breakeryu/OPENIB_RP2040/hardware/inno_Bottom_borad/06_PRODUCT/SMT_Bill of Materials-iono_bottom_pico.xls

Comment | Description | Designator | Footprint | Quantity | 编号
10nF 50V | 贴片电容 | C1 | 0402_C | 1 | C272878
220uF 16V | 贴片铝电解电容 8x10.2mm | C2 | SMD-EC-F8 | 1 | C87861 (https://item.szlcsc.com/89039.html)
1uF 50V | 贴片电容 | C3, C5 | 0603_C | 2 | C342951
47uF 50V | 贴片铝电解电容 | C4, C9 | SMD-EC-F6.3 | 2 | C88677
100nF 50V | 贴片电容 | C6, C10 | 0402_C | 2 | C152814
10uF (106) 10% 25V | 贴片电容 | C7, C8 | 0603_C | 2 | C76614
S1M | 肖特基二极管 | D1, D7 | DO-214AC | 2 | C161744
RS2MA-13-F | B230A-13-F,SCHOTTKY RECTIFIER | D2 | DIOD-SMA-1K | 1 | C156336
B340A-13-F | Transient Voltage Suppressor, 6.40 to 231 V, 16 V Stand-off Voltage, Uni-Directional, -55 to 155 degC, 2-pin DO-214AC, Pb-Free, Tape and Reel | D3 | DO-214AC | 1 | C85098
BAT54S,215 | 肖特基二极管 | D4, D8 | SOT-23-3 | 2 | C47546
SM6T33A | 3A 肖特基二极管 | D5 | DO-214AA | 1 | C133690
SS34-SMB(DO-214AA) | 3A 肖特基二极管 | D6 | DO-214AA | 1 | C1884574
MMSZ8V2T1G | Fast Switching Diode, 100 V, 0.15 A,?-65 to 150 degC,?2-Pin?SOD123,?RoHS,?Tape and Reel | D9, D10, D11, D12, D13 | SOD-123-1A | 5 | C235988
mSMD110-33V | 贴片保险，自恢复 | F1 | 1812_R | 1 | C70119
JK-SMD1210-005 | 贴片保险，自恢复 | F2, F3 | 1210_R | 2 | C409801
MWSA1004S-220MT | 功率电感 | L1 | MWSA1004S | 1 | C408489
BC817 | NPN贴片三极管 | Q1, Q3, Q4, Q5, Q6 | SOT-23-3 | 5 | C475629
BCX53-16 | PNP贴片三极管 | Q2 | SOT89_M | 1 | C713685
330K ±1% | 贴片电阻 | R1, R13 | 0402_R | 2 | C413116
45K3 ±1% | 贴片电阻 | R2, R14 | 0402_R | 2 | C144759
47K ±1% | 贴片电阻 | R3, R7, R10, R15, R18, R22 | 0402_R | 6 | C93943
1K8 ±1% | 贴片电阻 | R4, R16 | 0402_R | 2 | C102844
10KΩ ±1% | 贴片电阻 | R5, R12，R8, R20 | 0402_R | 4 | C144807
2K2±1% | 贴片电阻 | R6, R17 | 0402_R | 2 | C114762
3.24KΩ ±1% | 贴片电阻 | R9 | 0402_R | 1 | C11457
4K7 ±1% | 贴片电阻 | R19, R24, R25, R26, R27, R32, R33, R34, R35 | 0402_R | 9 | C105871
6K8 ±1% | 贴片电阻 | R21 | 0402_R | 1 | C93940
3K3 ±1% | 贴片电阻 | R28, R31 | 0402_R | 2 | C325420
1K ±1% | 贴片电阻 | R29, R30 | 0402_R | 2 | C144789
TPS5430DDA | 5.5V to 36V Input, 3A, 500kHz Step-Down Converter 8-SO PowerPAD 0 to 0 | U1 | DDA0008J_L | 1 | C9864
MCP607T-I/SN | Dual Operational Amplifier, 3 to 32 V, 0 to 70 degC, 8-Pin SOIC (D), Green (RoHS & no Sb/Br), Tape and Reel | U2 | D0008A_L | 1 | C411629
SY6280AAAC | USB电子开关，电流保护 | U3 | SOT-23-5 | 1 | C207620
