breakeryu/OPENIB_RP2040/hardware/inno_Bottom_borad/06_PRODUCT/iono_bottom_pico.DXF

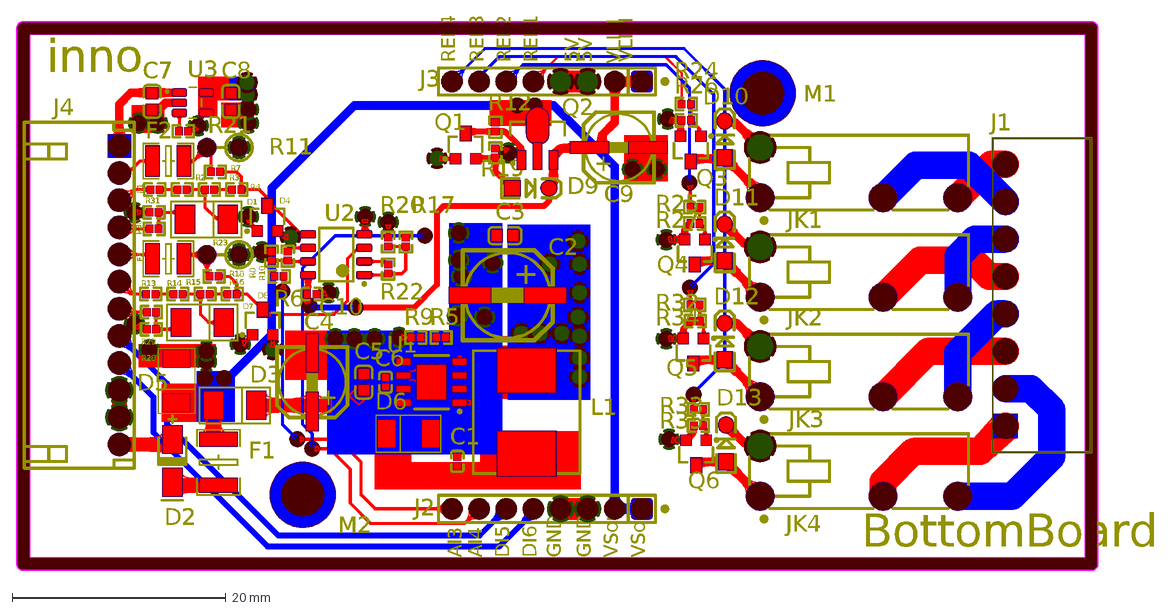
[picture p13: CAD file, 2023-02-28]
hardware/inno_Bottom_borad/06_PRODUCT/iono_bottom_pico.DXF
BottomBoard
inno
VSout
GND
DI6
DI5
AI4
AI3
VLIM
5V
REL1
REL2
REL3
REL4
M2
M1
U3
U2
U1
R35
R34
R33
R32
R31
R30
R29
R28
R27
R26
R25
R24
R23
R22
R21
R20
R19
R18
R17
R16
R15
R14
R13
R12
R11
R10
R9
R8
R7
R6
R5
R4
R3
R2
R1
Q6
Q5
Q4
Q3
Q2
Q1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
