breakeryu/OPENIB_RP2040/software/ionoRp2040/src/mpu6050/examples/MPU6050_DMP6_using_DMP_V6v12/MPUplane/data/biplane.obj

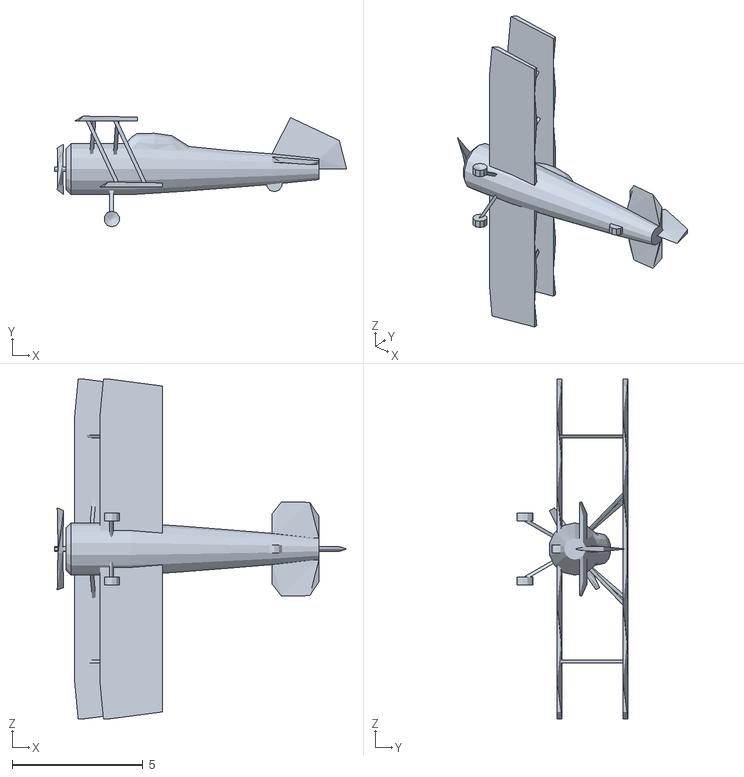
[picture p14: CAD file, 2023-02-28]
software/ionoRp2040/src/mpu6050/examples/MPU6050_DMP6_using_DMP_V6v12/MPUplane/data/biplane.obj
11.2 x 4.23 x 13.0
