breakeryu/OPENIB_RP2040/hardware/iono_pico/iono_pico.pdf

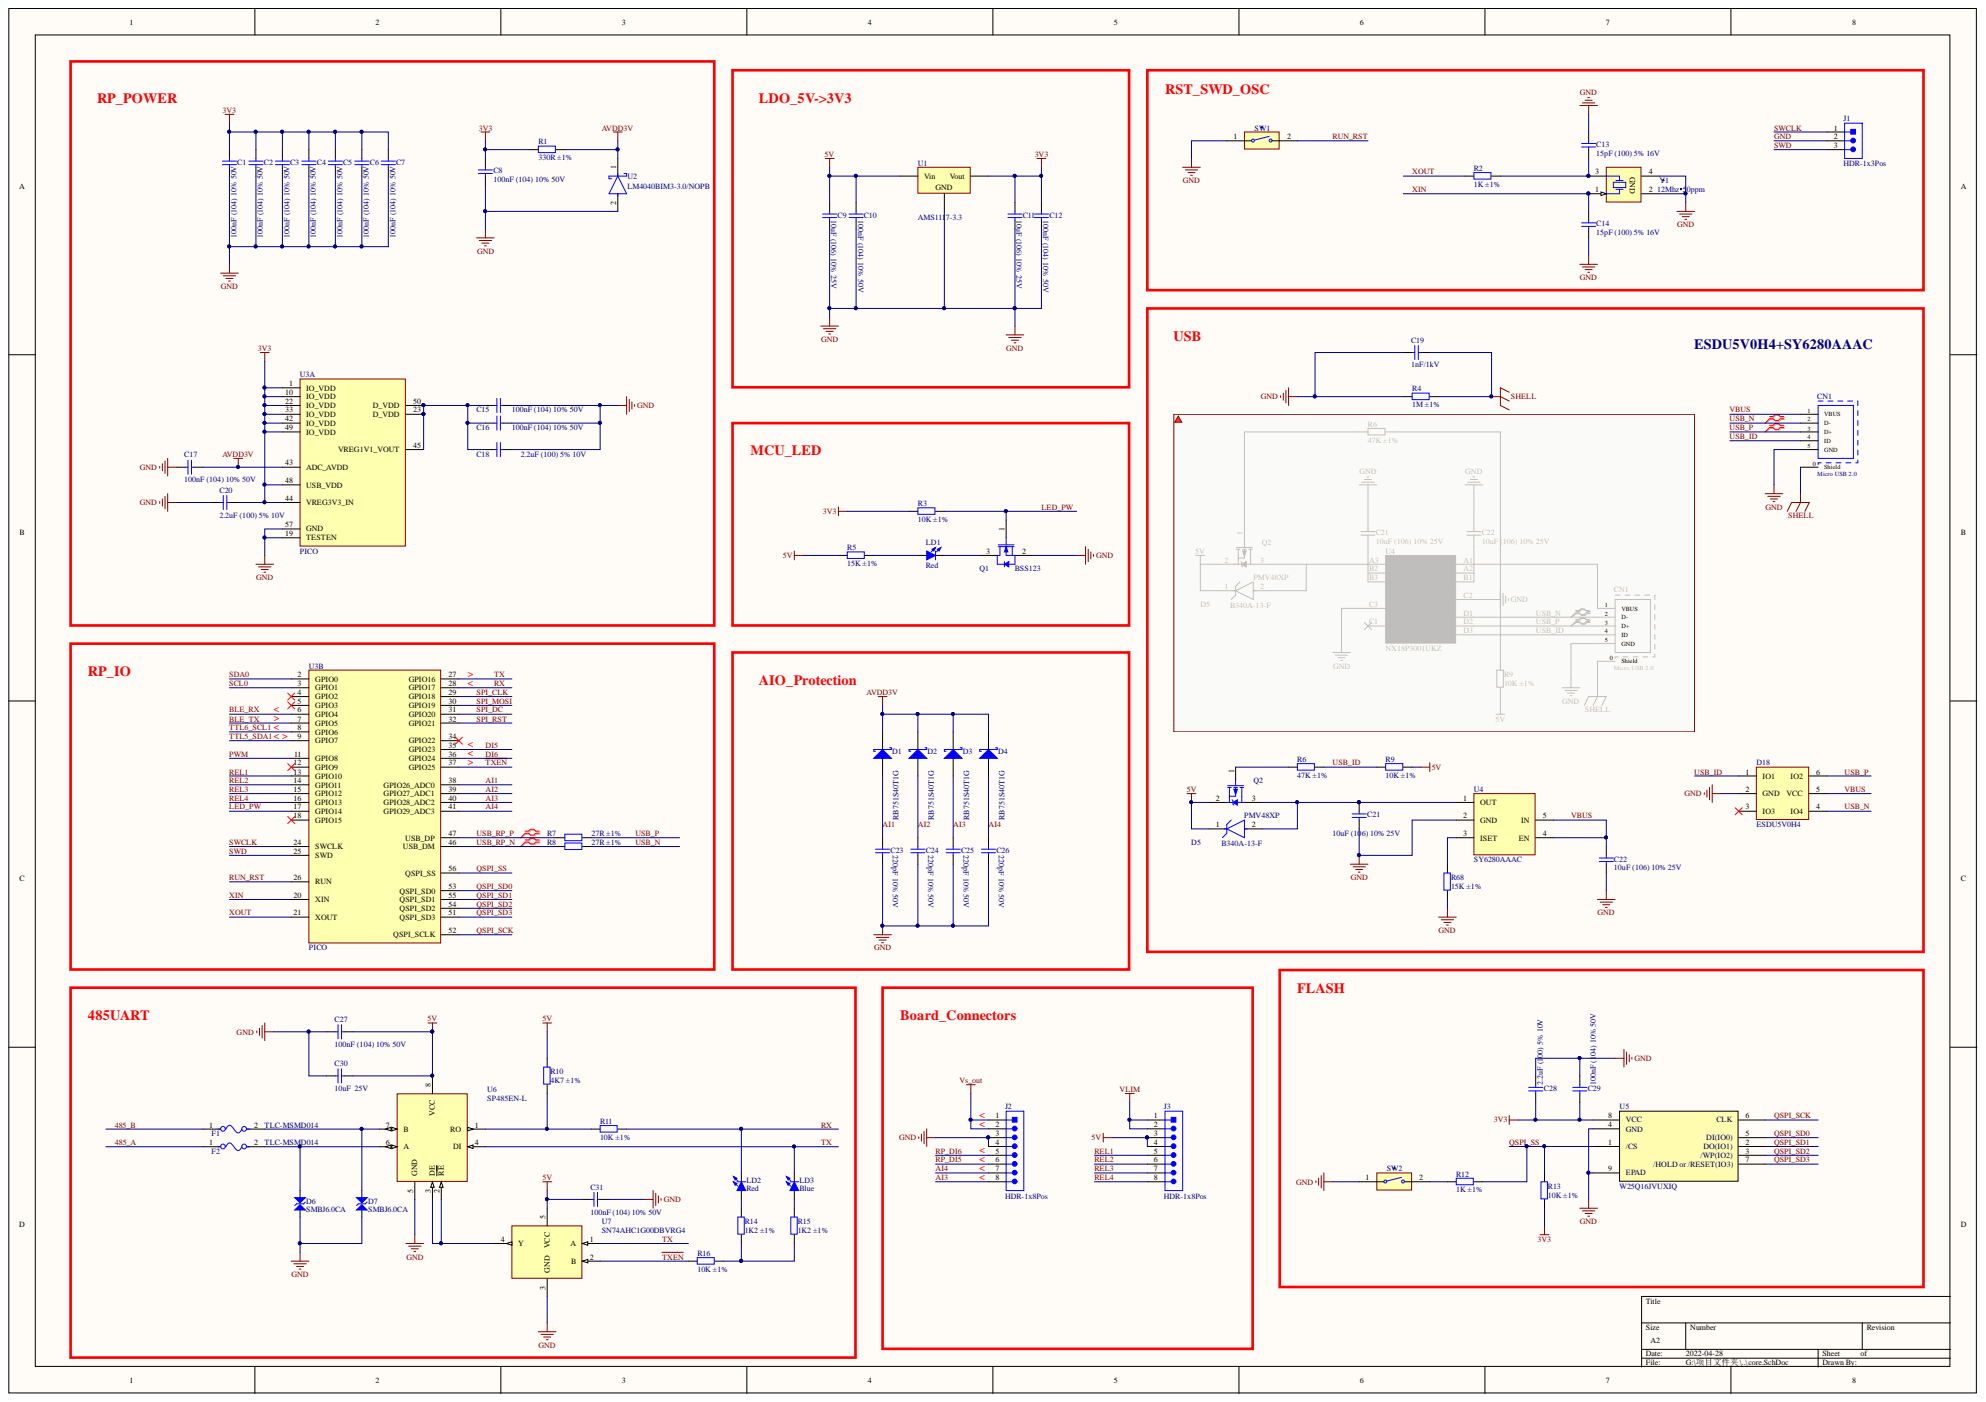
[picture p15: page 1]

USB_ID | ID 4

5V | | | GND 5

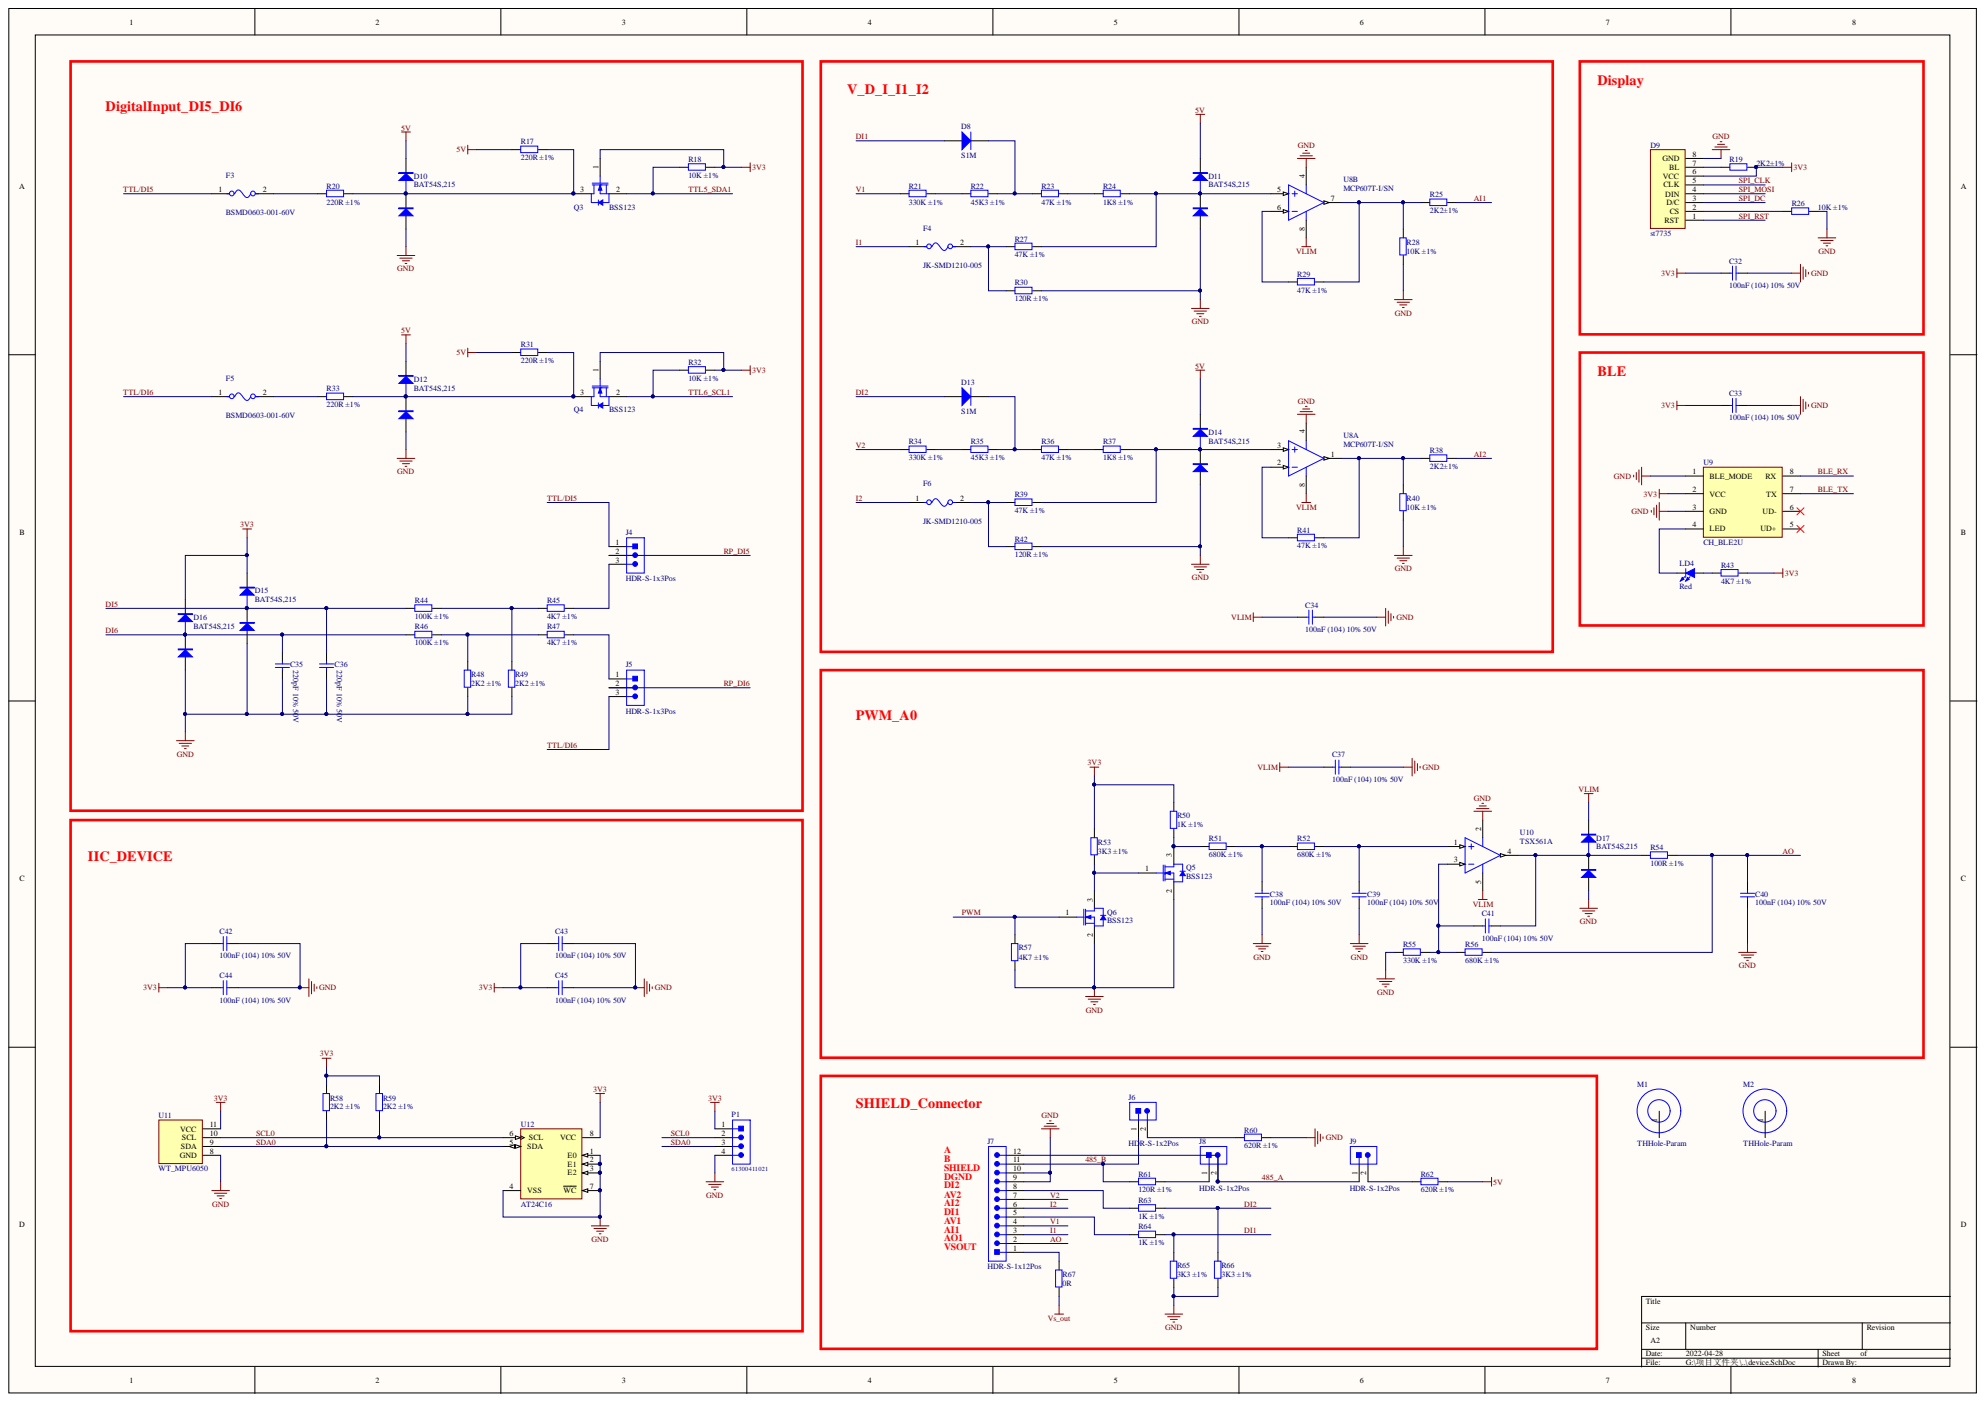
[picture p16: page 2]
