breakeryu/OPENIB_RP2040/hardware/sch/ref_sch/ionorp-sch.pdf

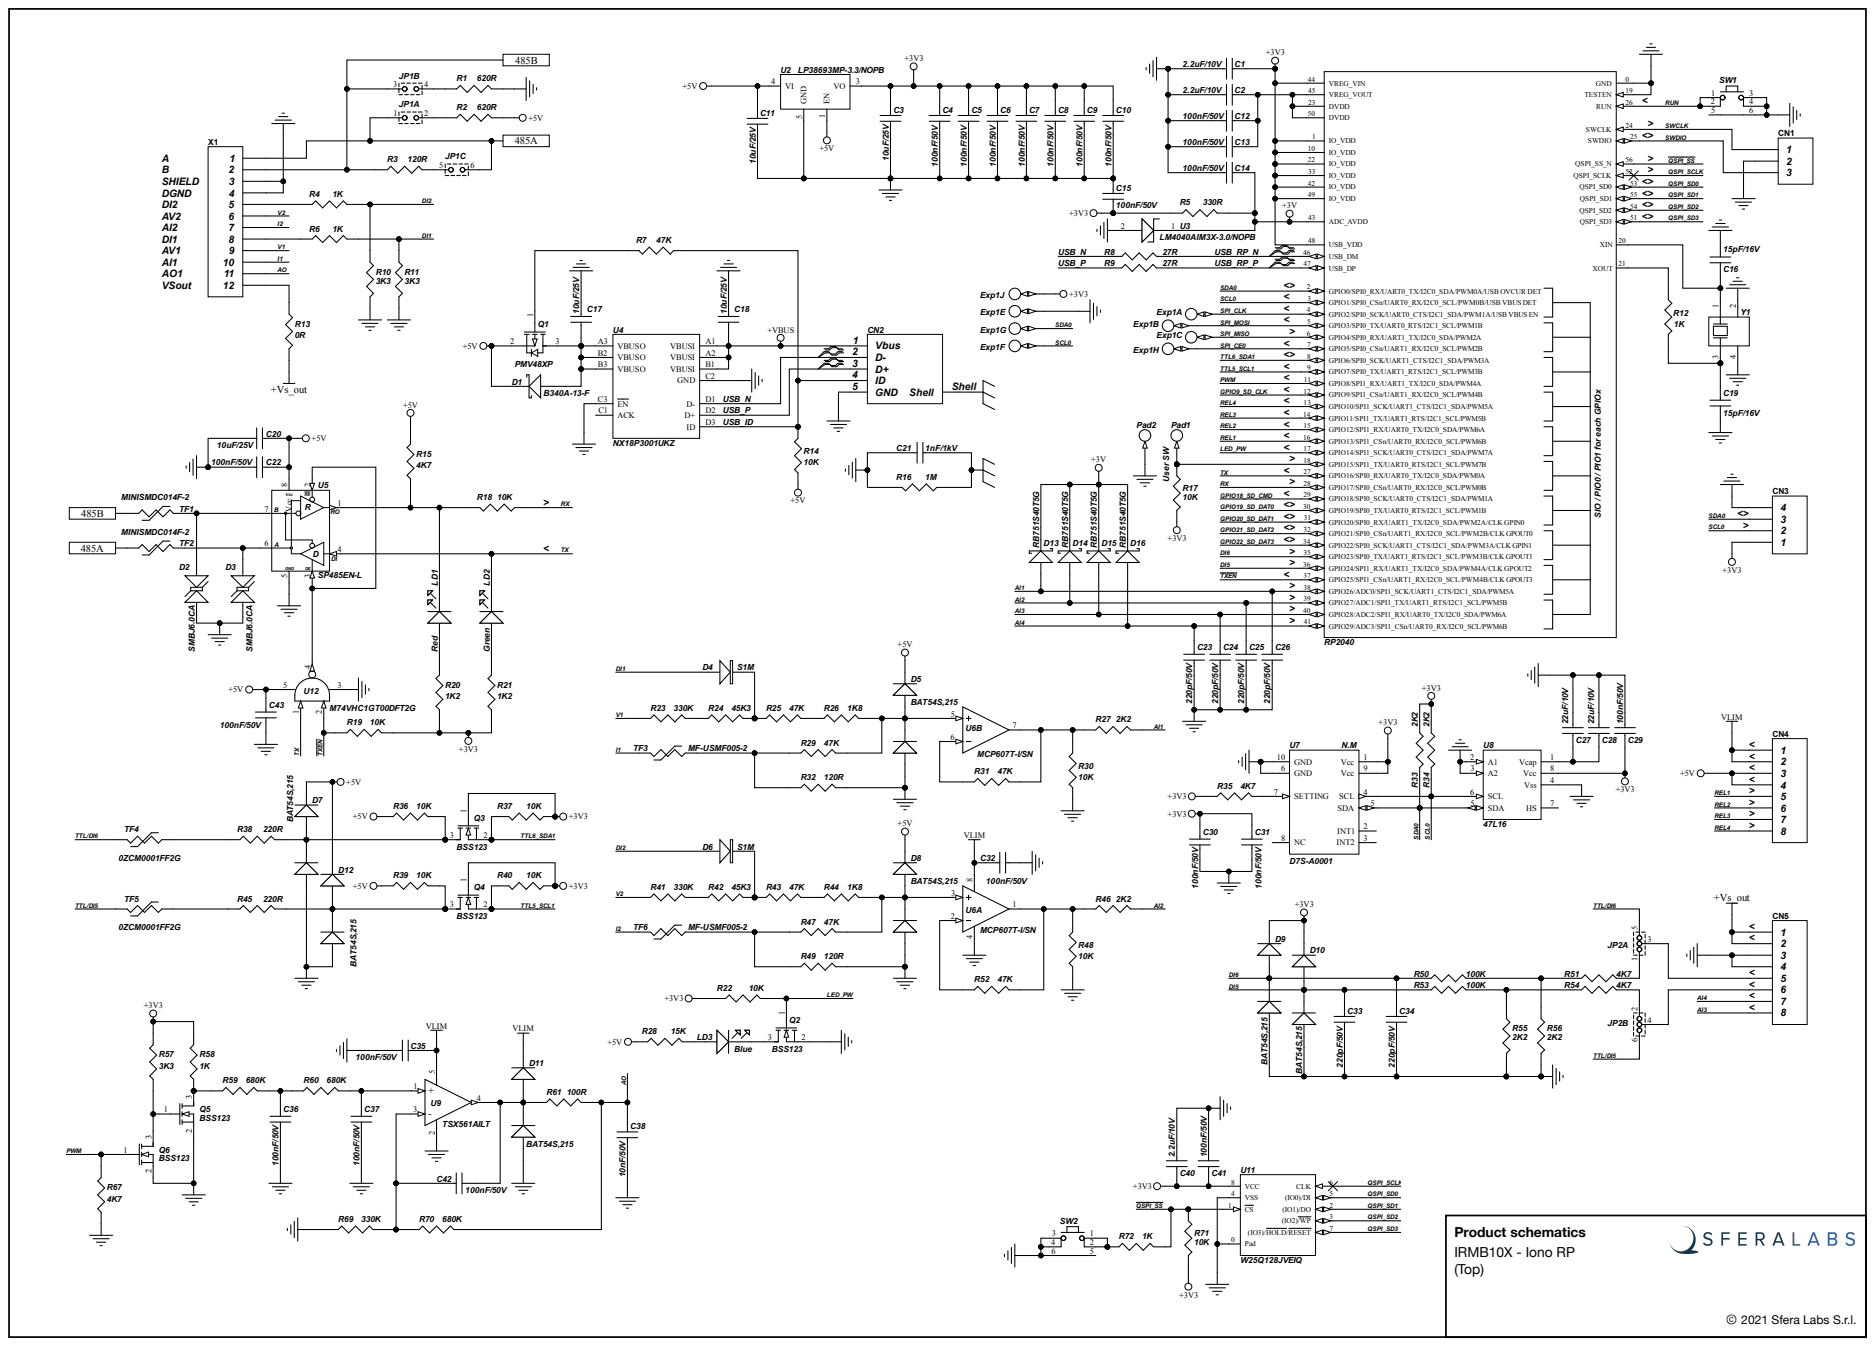
[picture p17: page 1]

Rev.
IRMB10X - Iono RP Tit.: IonoRP: Input/Output module based on RaspberryPi RP2040 microcontroller (Top)

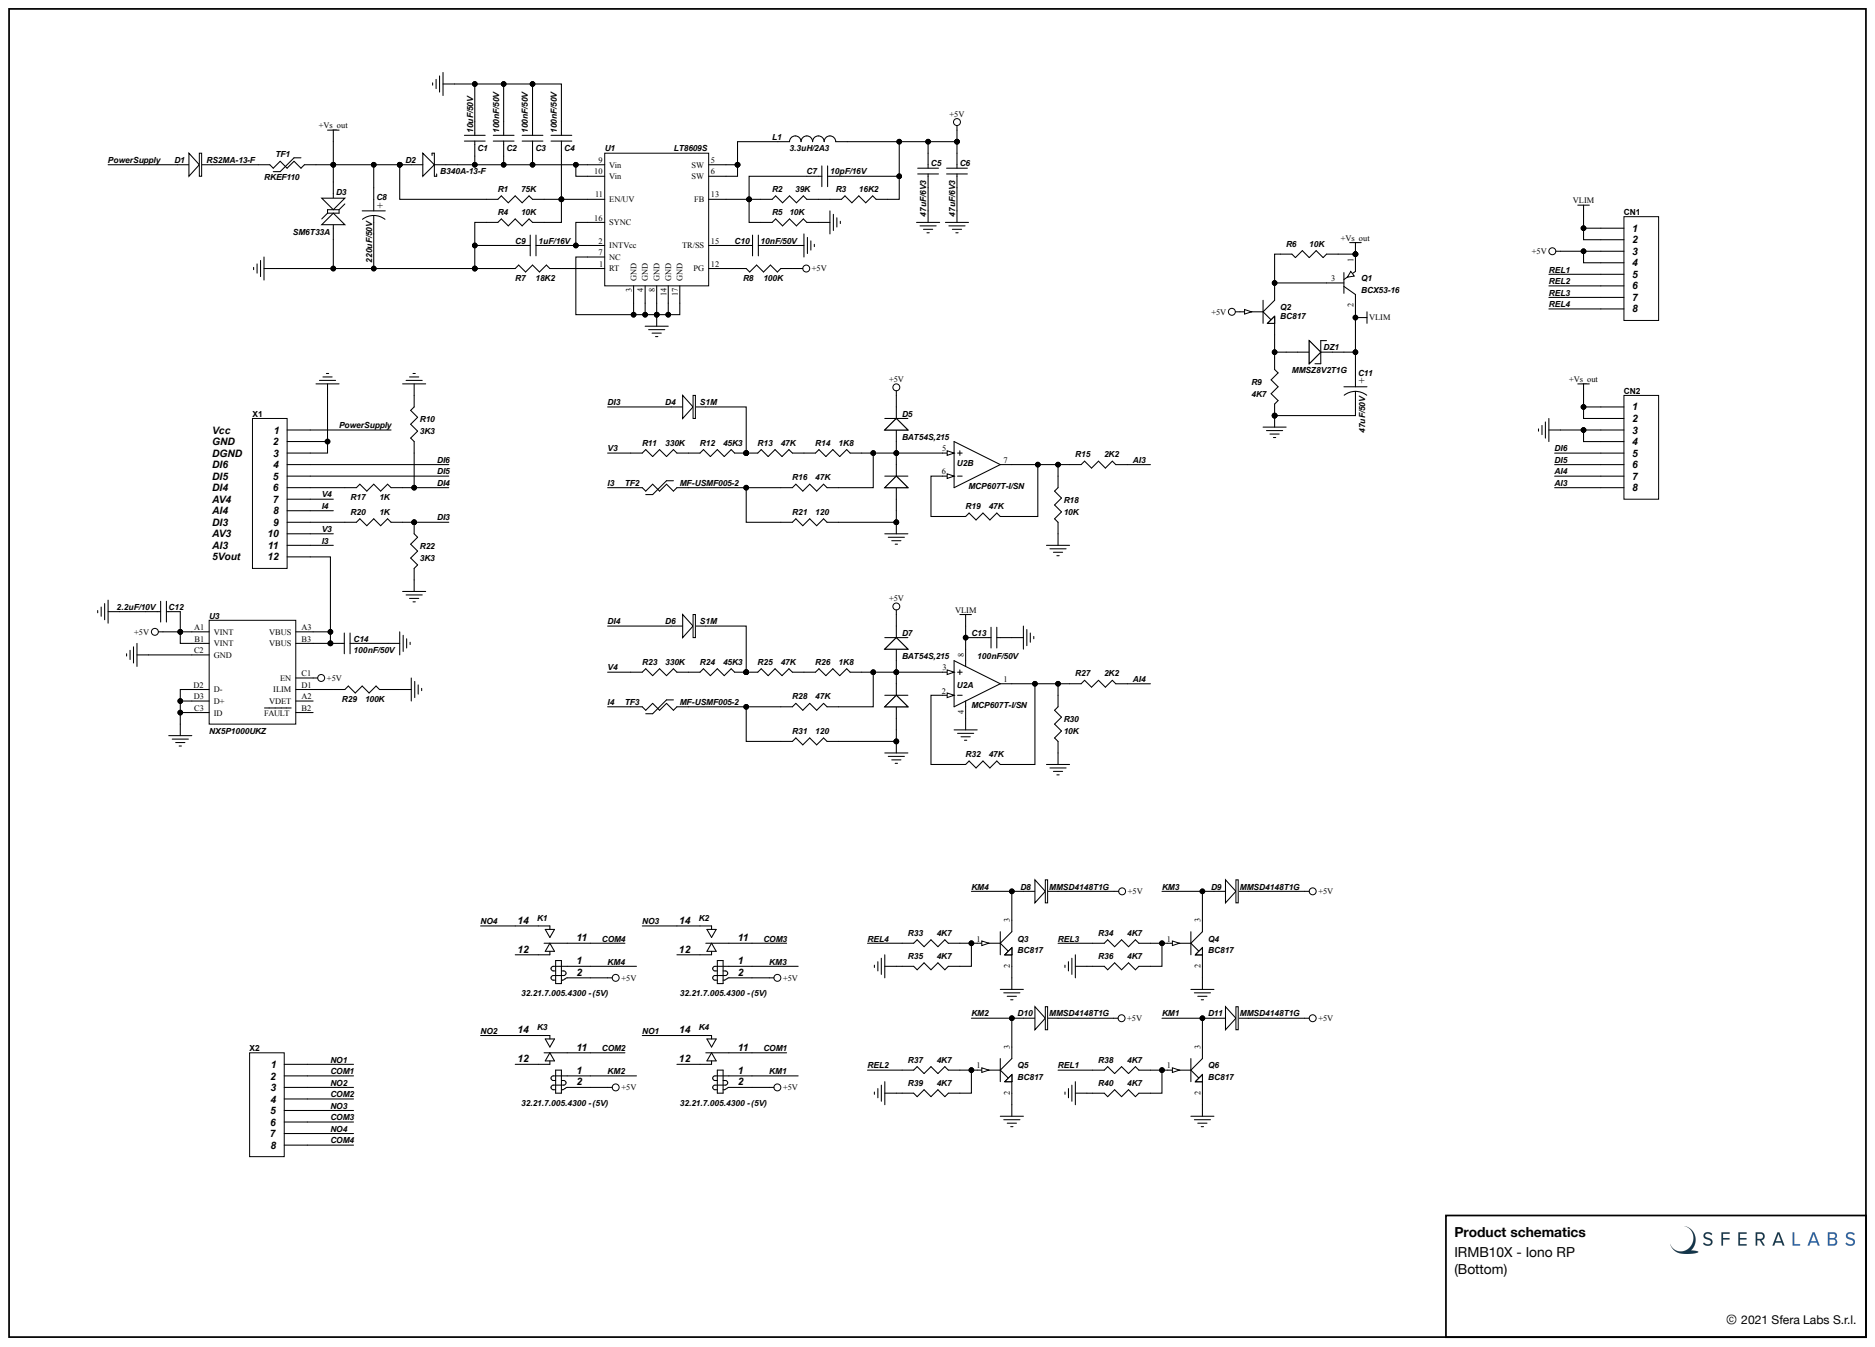
[picture p18: page 2]

IonoRP: Input/Output module based
on RaspberryPi RP2040 microcontroller
