breakeryu/OPENIB_RP2040/hardware/inno_Bottom_borad/inno_Bottom_borad.pdf

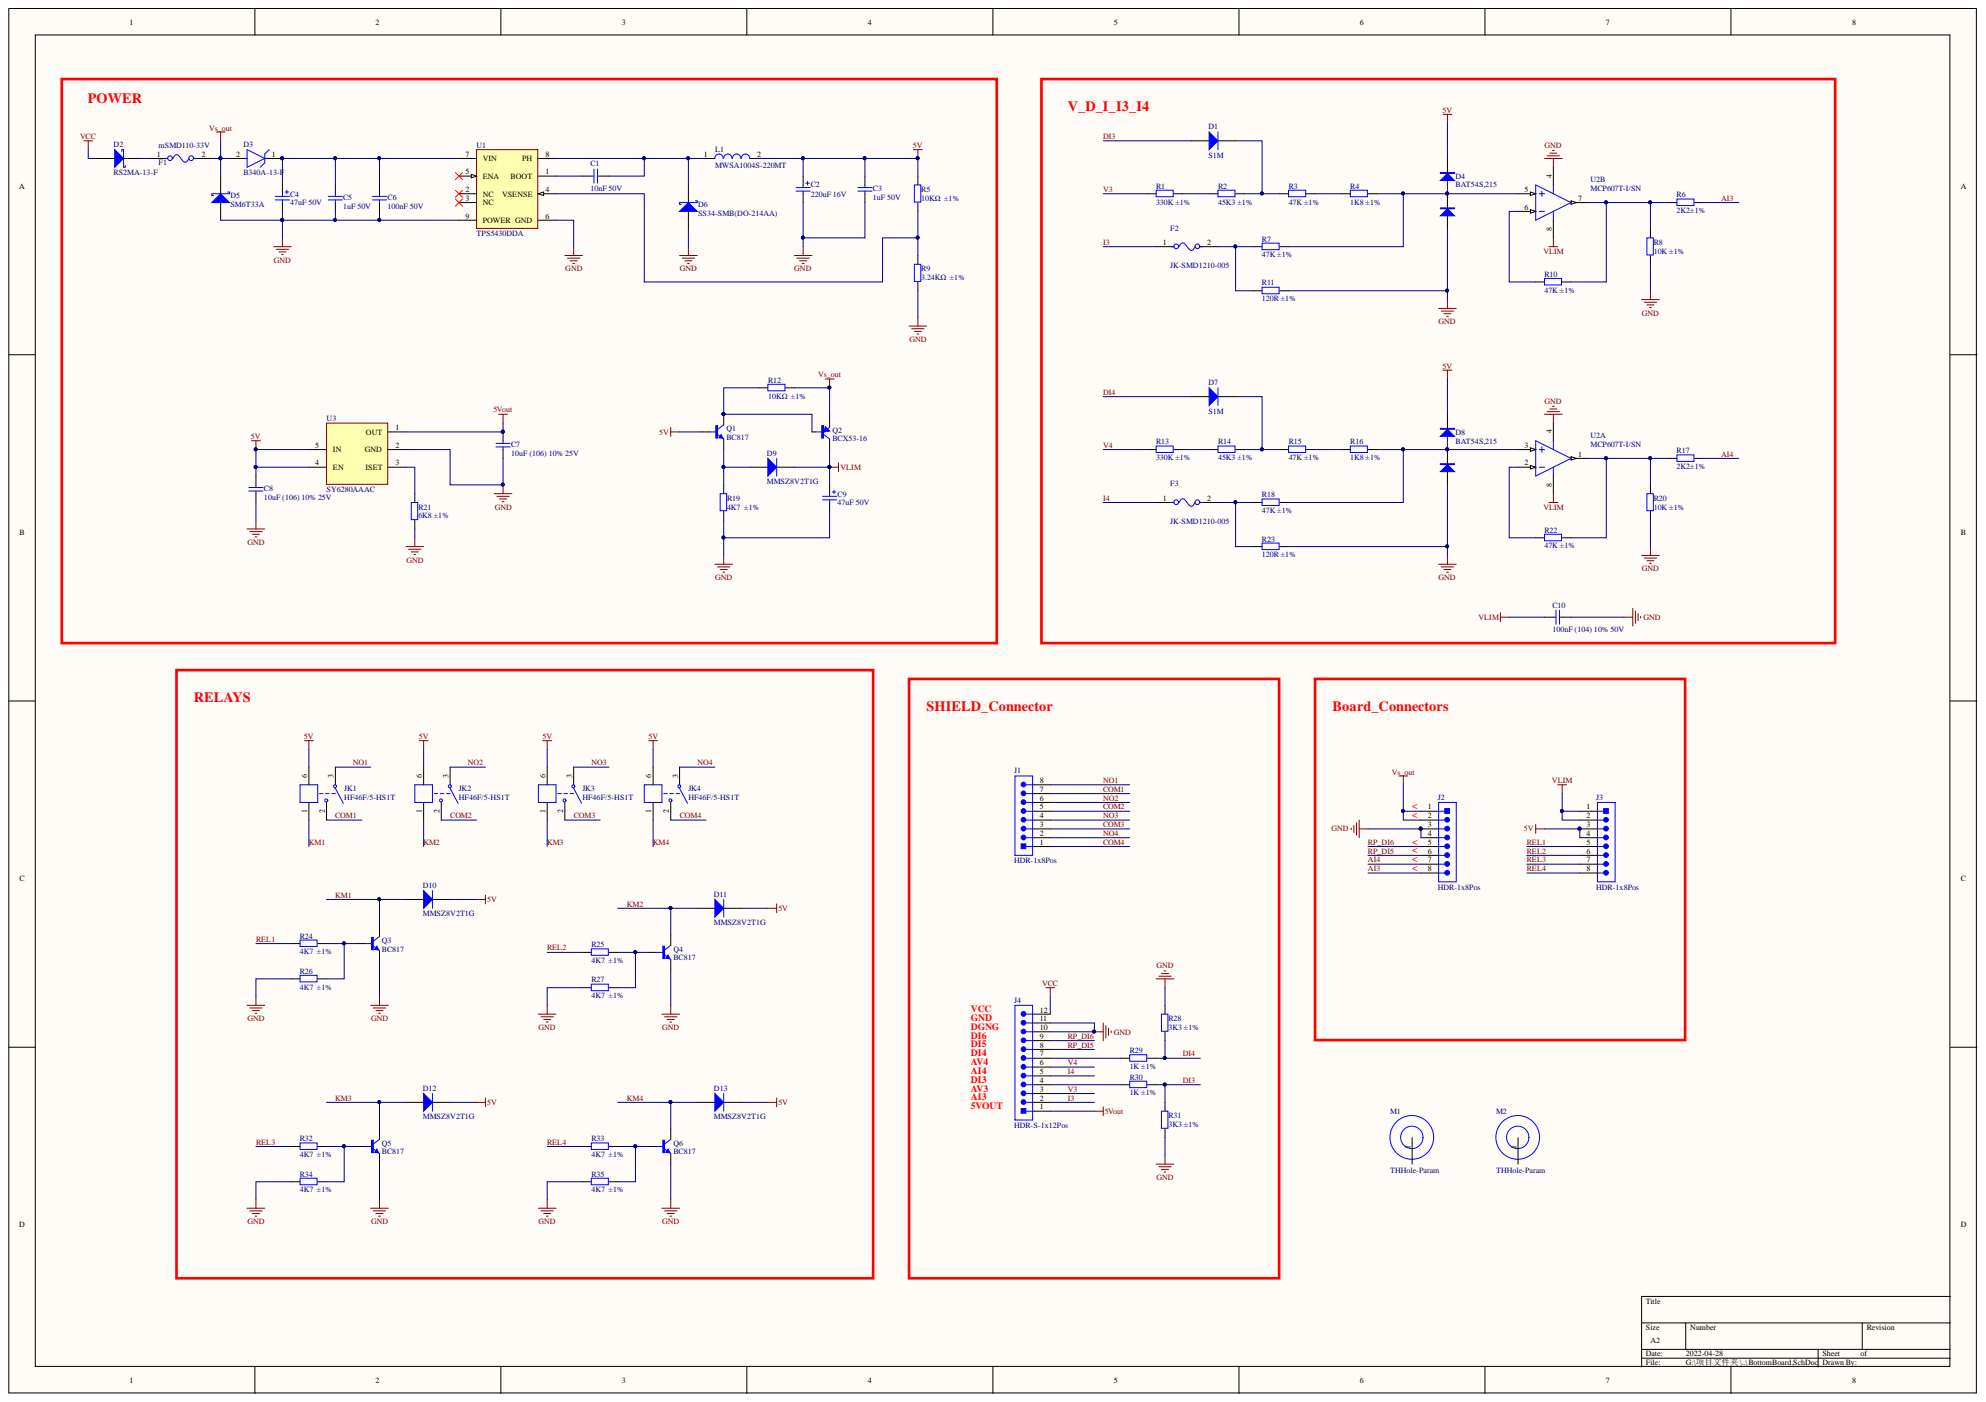
[picture p19: page 1]
