breakeryu/OPENIB_RP2040/hardware/iono_pico/05_DOC/装配.pdf

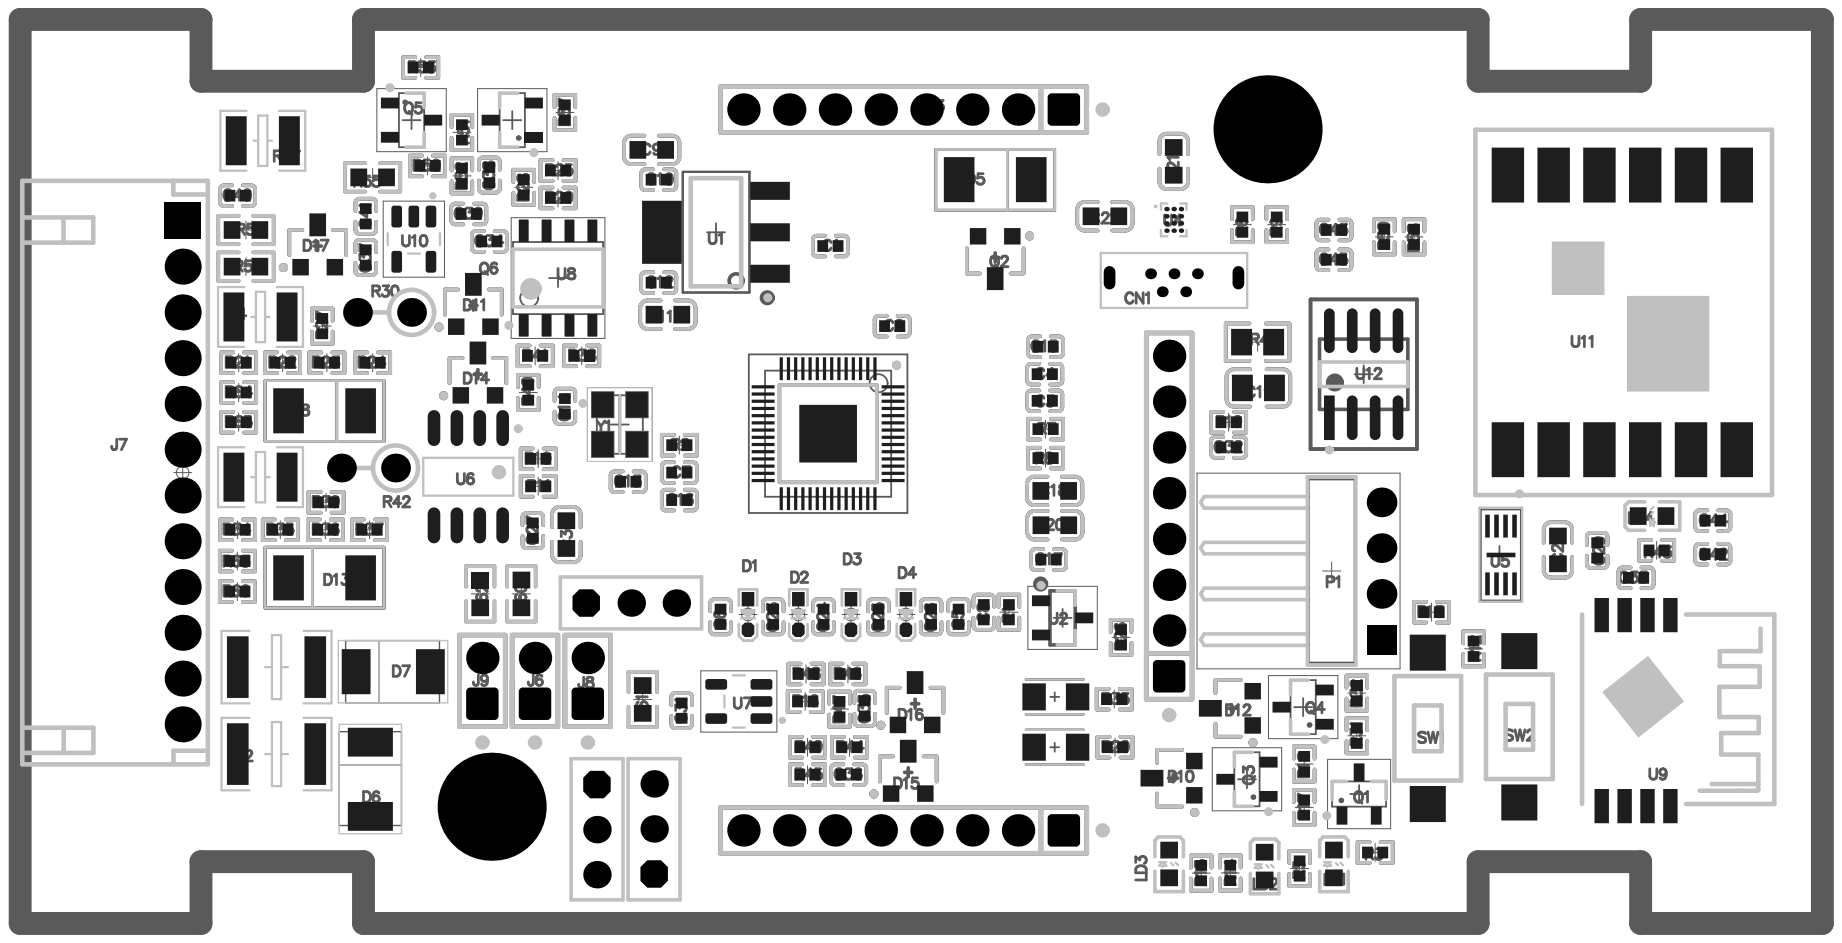
[picture p20: page 1]

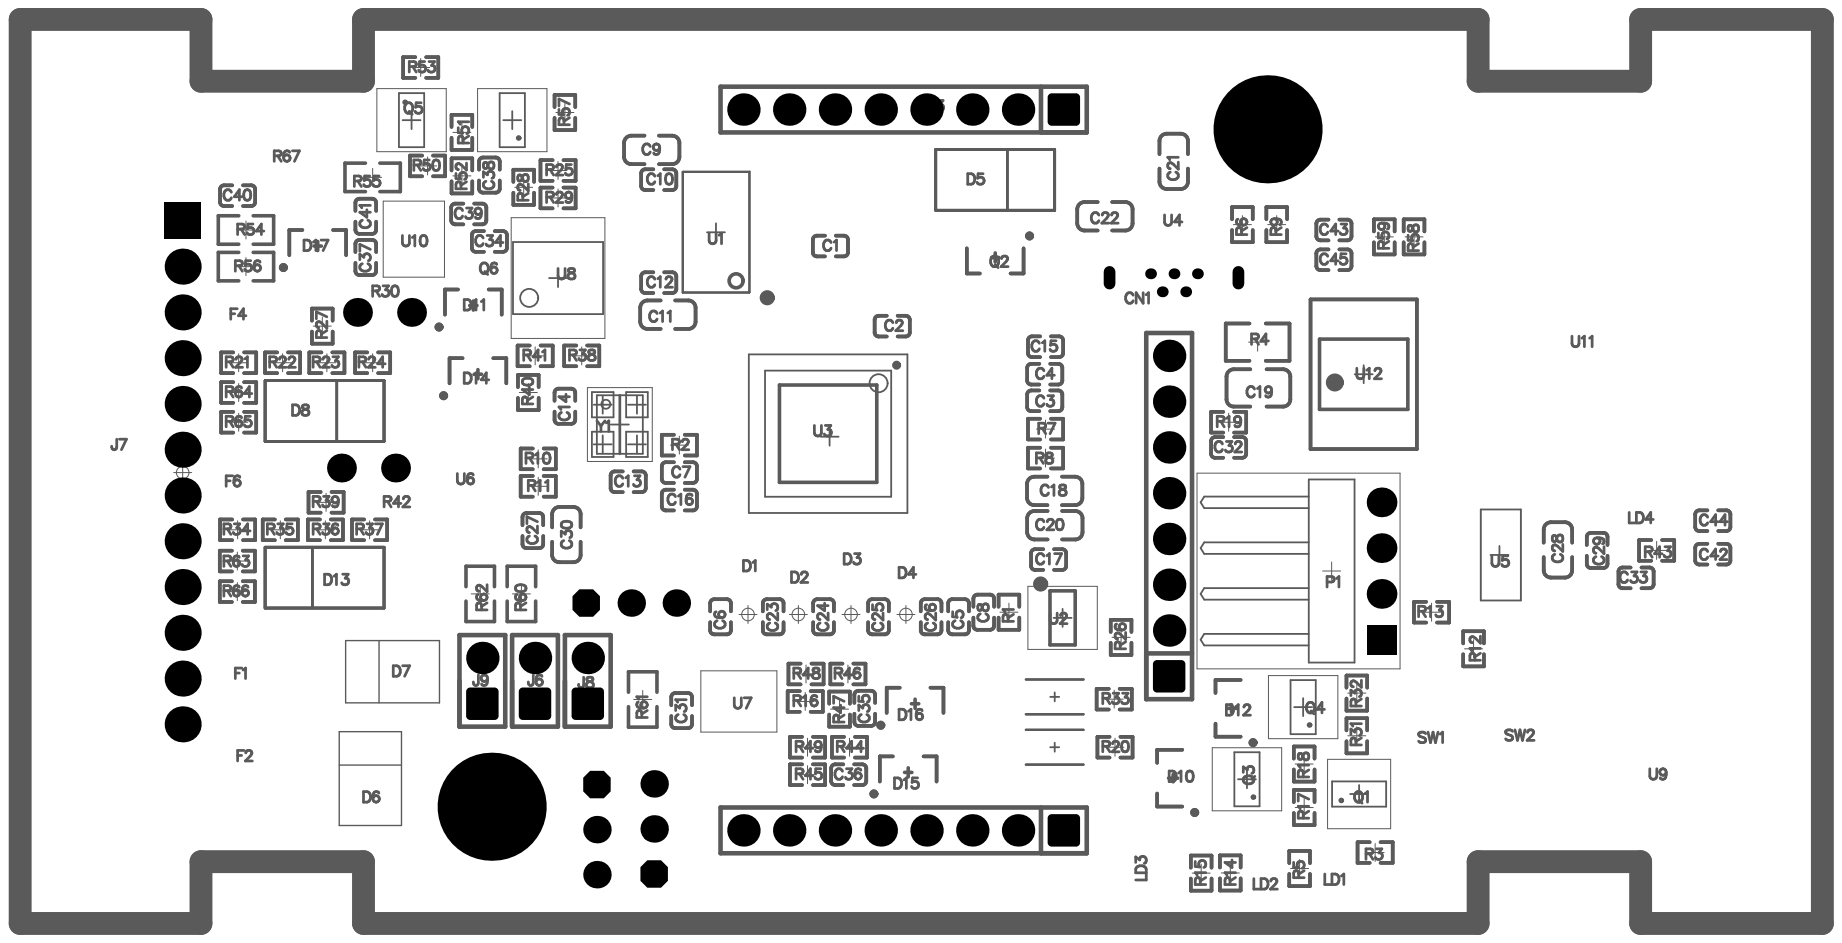
[picture p21: page 2]

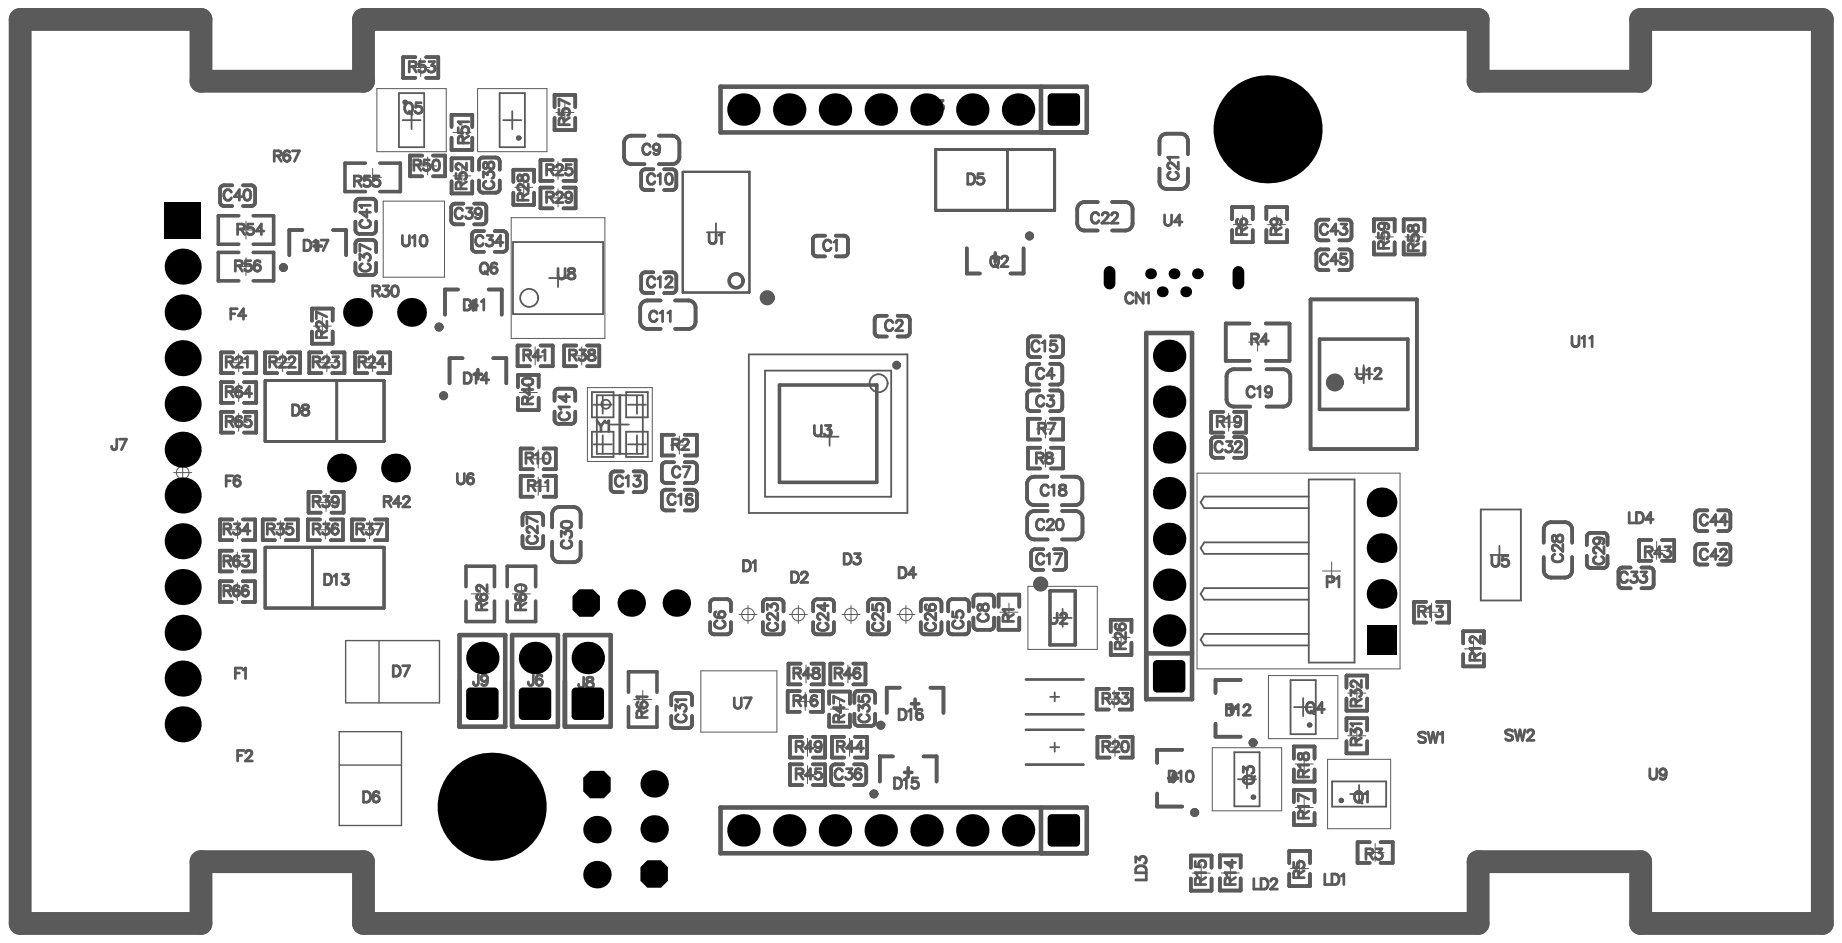
[picture p22: page 3]
