breakeryu/OPENIB_RP2040/doc/图片/结构框图.pdf

RP2040

VS+ | +V

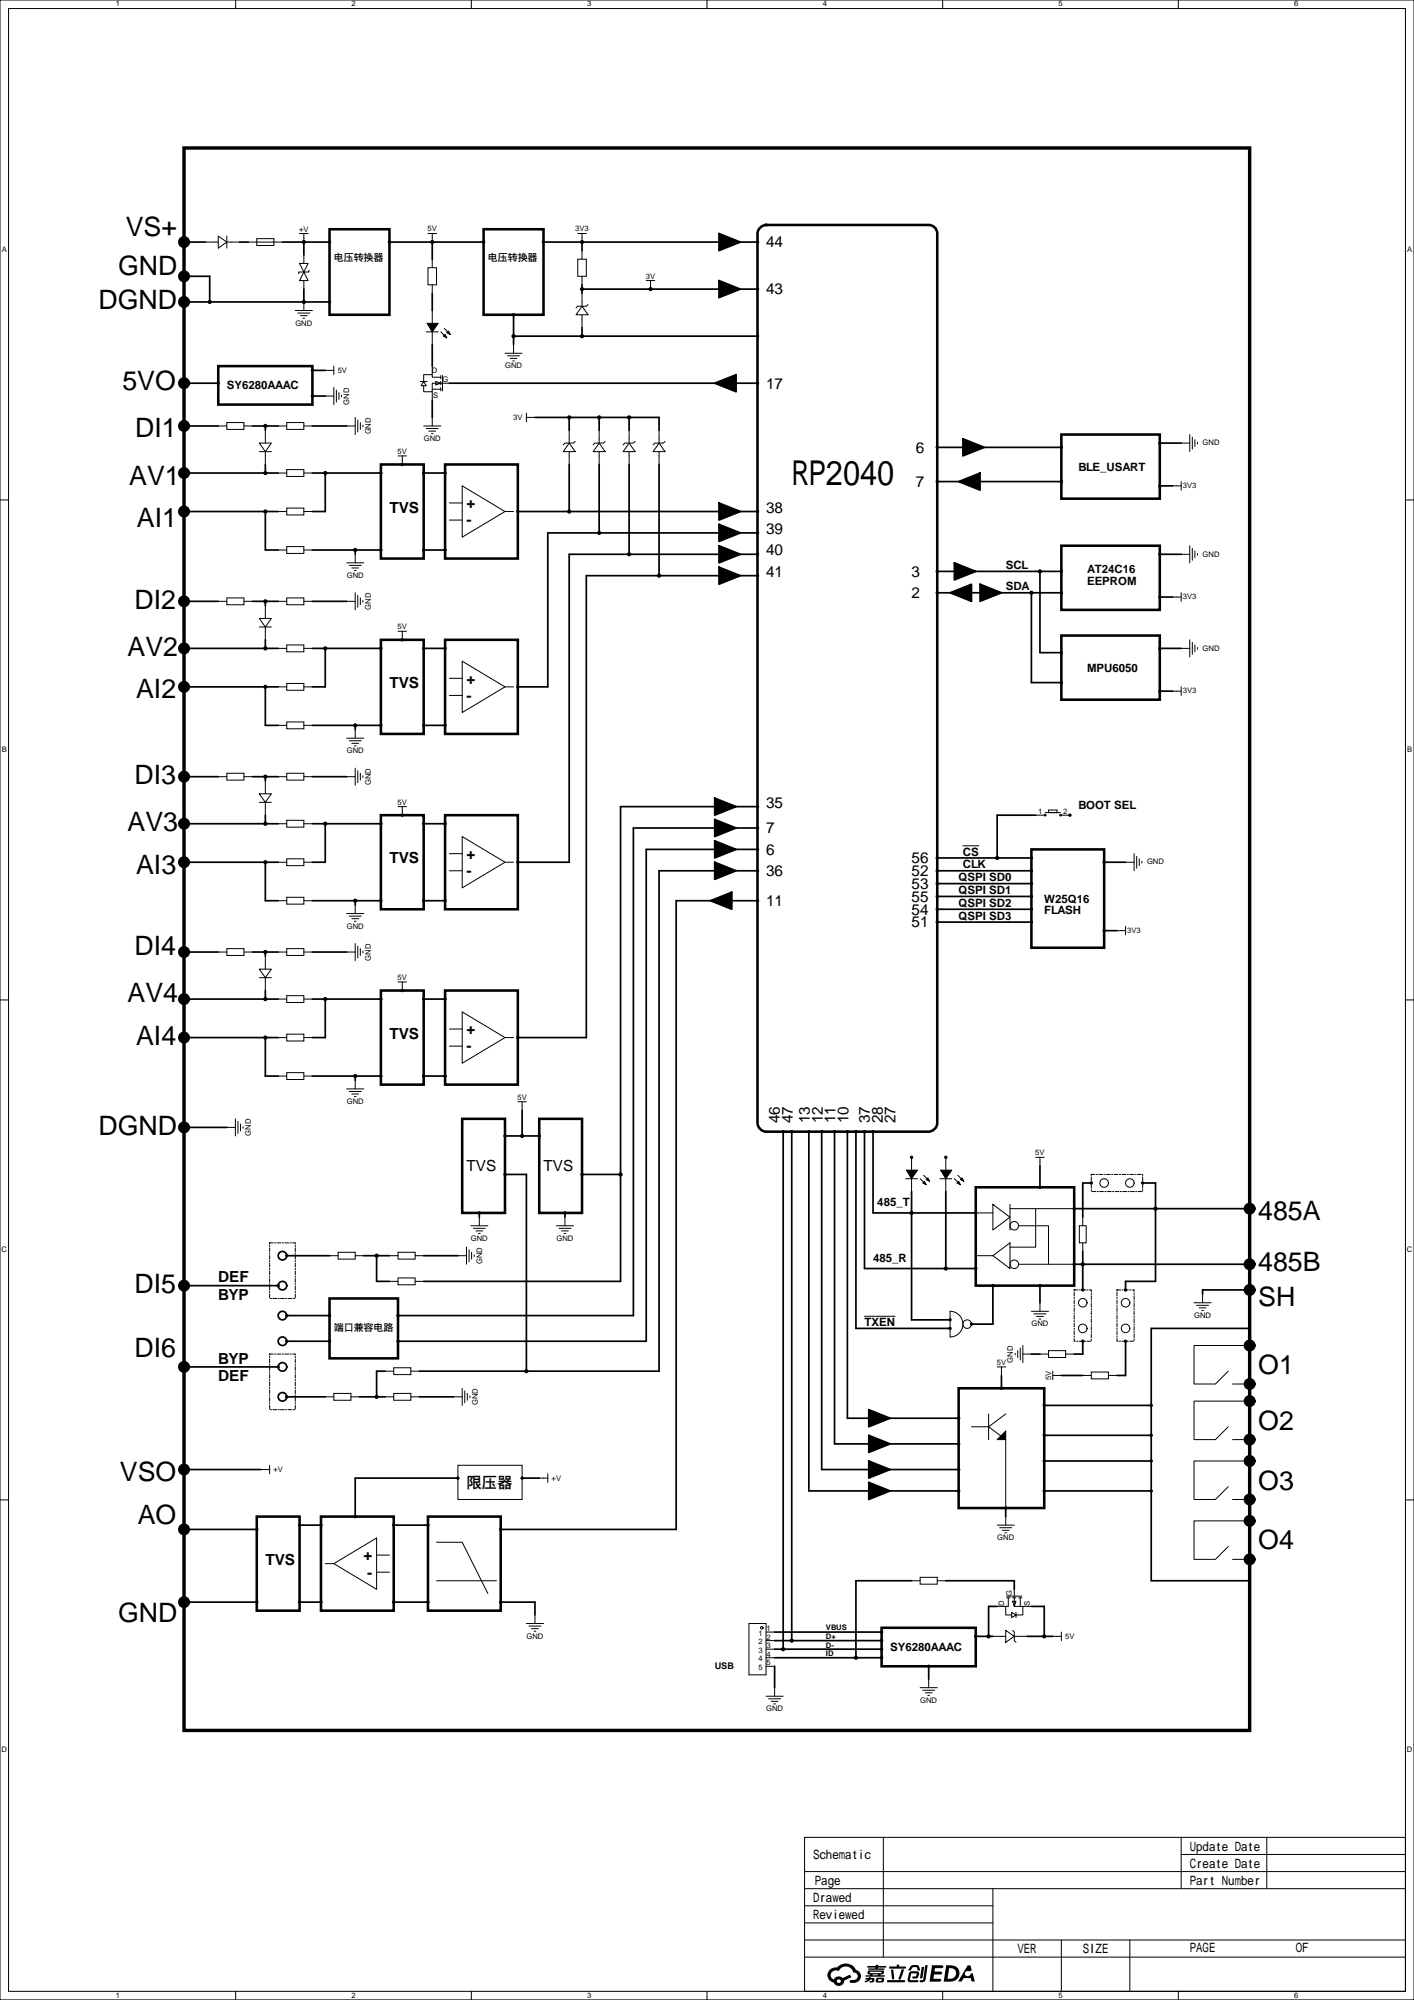
[picture p23: page 1]
