breakeryu/OPENIB_RP2040/(list of files, drawings)

Other design files:
hardware/inno_Bottom_borad/01_sch/BottomBoard.SchDoc
hardware/inno_Bottom_borad/01_sch/SheetStruct.SchDoc
hardware/inno_Bottom_borad/03_LIB/PcbLib1.PcbLib
hardware/inno_Bottom_borad/03_LIB/Schlib1.SchLib
hardware/inno_Bottom_borad/inno_Bottom_borad.PrjPcb
hardware/iono_pico/01_sch/core.SchDoc
hardware/iono_pico/01_sch/device.SchDoc
hardware/iono_pico/01_sch/SheetStruct.SchDoc
hardware/iono_pico/03_LIB/PcbLib1.PcbLib
hardware/iono_pico/03_LIB/Schlib1.SchLib
hardware/iono_pico/iono_pico.PrjPcb
hardware/iono_pico/SnapDocs/NTB0104UK,012.PcbLib
hardware/iono_pico/SnapDocs/NTB0104UK,012.SchLib
hardware/iono_pico/SnapDocs/PMV48XPAR.PcbLib
hardware/iono_pico/SnapDocs/PMV48XPAR.SchLib
hardware/iono_pico/SnapDocs/SN74AHC1G00DBVRG4.PcbLib
hardware/iono_pico/SnapDocs/SN74AHC1G00DBVRG4.SchLib
hardware/iono_pico/SnapDocs/SP485EN-L.PcbLib
hardware/iono_pico/SnapDocs/SP485EN-L.SchLib
