breakeryu/OPENIB_RP2040/(commit log)

2023-02-28 创建初始仓库
    [Bill of Materials-iono_bottom_pico.csv, Bill of Materials-iono_bottom_pico.xls, Bill of Materials-iono_pico.csv, Bill of Materials-iono_pico1.xls, BottomBoard.SchDoc, NTB0104UK,012.PcbLib, NTB0104UK,012.SchLib, PMV48XPAR.PcbLib]
2023-03-01 通讯协议文档更新。
    开始构思485通讯协议。
2023-03-02 补充通讯协议
2023-03-03 补充EEPROM配置协议
2023-03-04 修改EEPROM配置文档
2023-03-05 在mconfig.h添加代码
2023-03-07 mconfig.cpp增加代码
